yenthusiastic/EMRP19/media/web-login.png

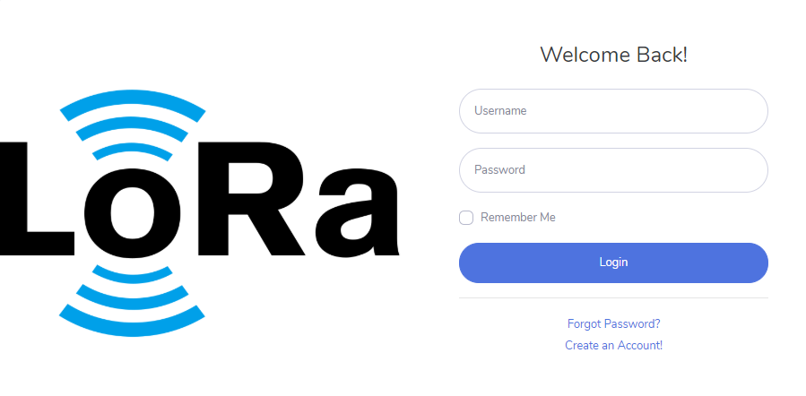
media/web-login.png
