yenthusiastic/EMRP19/code/database/paper_bins.csv

Name | Latitude | Longitude | lfd# Nr# | Stadtteil | Anzahl_beh | ort | Straße | Art | Abfuhrtag | Woche-g-ug | Telefon | Zeitbedarf
Papierkorb 200000402 | 51.41055037 | 6.584027857 | 1139 |  | 1 | Moers |  | Papierkorb |  |  |  | 0.5
Papierkorb 200001443 | 51.41388008 | 6.583538186 | 1140 |  | 1 | Moers |  | Papierkorb |  |  |  | 0.5
Papierkorb 200001526 | 51.40912285 | 6.591295972 | 1141 |  | 1 | Moers |  | Papierkorb |  |  |  | 0.5
Papierkorb 200001439 | 51.41414646 | 6.58943519 | 1142 |  | 1 | Moers |  | Papierkorb |  |  |  | 0.5
Papierkorb 200001440 | 51.41527005 | 6.589190606 | 1143 |  | 1 | Moers |  | Papierkorb |  |  |  | 0.5
Papierkorb 200001441 | 51.41563886 | 6.589281969 | 1144 |  | 1 | Moers |  | Papierkorb |  |  |  | 0.5
Papierkorb 200001436 | 51.42117812 | 6.585614551 | 1145 |  | 1 | Moers |  | Papierkorb |  |  |  | 0.5
Papierkorb 200000399 | 51.41945011 | 6.591256745 | 1146 |  | 1 | Moers |  | Papierkorb |  |  |  | 0.5
Papierkorb 200001432 | 51.4212601 | 6.588204056 | 1147 |  | 1 | Moers |  | Papierkorb |  |  |  | 0.5
Papierkorb 200001433 | 51.4211679 | 6.588633545 | 1148 |  | 1 | Moers |  | Papierkorb |  |  |  | 0.5
Papierkorb 200001434 | 51.42098693 | 6.588387201 | 1149 |  | 1 | Moers |  | Papierkorb |  |  |  | 0.5
Papierkorb 200001435 | 51.42090152 | 6.588645028 | 1150 |  | 1 | Moers |  | Papierkorb |  |  |  | 0.5
Papierkorb 200001437 | 51.42043029 | 6.588135744 | 1151 |  | 1 | Moers |  | Papierkorb |  |  |  | 0.5
Papierkorb 200001438 | 51.42075132 | 6.588340262 | 1152 |  | 1 | Moers |  | Papierkorb |  |  |  | 0.5
Papierkorb 200001442 | 51.42075811 | 6.588757345 | 1153 |  | 1 | Moers |  | Papierkorb |  |  |  | 0.5
Papierkorb 200001430 | 51.42186804 | 6.588427769 | 1154 |  | 1 | Moers |  | Papierkorb |  |  |  | 0.5
Papierkorb 200001431 | 51.42258176 | 6.588049075 | 1155 |  | 1 | Moers |  | Papierkorb |  |  |  | 0.5
Papierkorb 200000601 | 51.47922792 | 6.584357852 | 1156 |  | 1 | Moers |  | Papierkorb |  |  |  | 0.5
Papierkorb 200000605 | 51.47161908 | 6.591730574 | 1157 |  | 1 | Moers |  | Papierkorb |  |  |  | 0.5
Papierkorb 200000606 | 51.47160206 | 6.591788242 | 1158 |  | 1 | Moers |  | Papierkorb |  |  |  | 0.5
Papierkorb 200000602 | 51.47904695 | 6.588112274 | 1159 |  | 1 | Moers |  | Papierkorb |  |  |  | 0.5
Papierkorb 200000072 | 51.4902792 | 6.572217587 | 1160 |  | 1 | Moers |  | Papierkorb |  |  |  | 0.5
Papierkorb 200000070 | 51.4864884 | 6.589001091 | 1161 |  | 1 | Moers |  | Papierkorb |  |  |  | 0.5
Papierkorb 200000071 | 51.48623569 | 6.589025818 | 1162 |  | 1 | Moers |  | Papierkorb |  |  |  | 0.5
Papierkorb 200000068 | 51.48953808 | 6.591559835 | 1163 |  | 1 | Moers |  | Papierkorb |  |  |  | 0.5
Papierkorb 200000069 | 51.48918293 | 6.588444868 | 1164 |  | 1 | Moers |  | Papierkorb |  |  |  | 0.5
Papierkorb 200000435 | 51.48936734 | 6.590636065 | 1165 |  | 1 | Moers |  | Papierkorb |  |  |  | 0.5
Papierkorb 200000436 | 51.48910096 | 6.588473031 | 1166 |  | 1 | Moers |  | Papierkorb |  |  |  | 0.5
Papierkorb 200000437 | 51.49044994 | 6.586992955 | 1167 |  | 1 | Moers |  | Papierkorb |  |  |  | 0.5
Papierkorb 200000438 | 51.49082218 | 6.586709563 | 1168 |  | 1 | Moers |  | Papierkorb |  |  |  | 0.5
Papierkorb 200000439 | 51.49065823 | 6.586735966 | 1169 |  | 1 | Moers |  | Papierkorb |  |  |  | 0.5
Papierkorb 200000417 | 51.49748161 | 6.590841757 | 1170 |  | 1 | Moers |  | Papierkorb |  |  |  | 0.5
Papierkorb 200001476 | 51.40488815 | 6.60016587 | 1171 |  | 1 | Moers |  | Papierkorb |  |  |  | 0.5
Papierkorb 200001445 | 51.40803345 | 6.595880371 | 1172 |  | 1 | Moers |  | Papierkorb |  |  |  | 0.5
Papierkorb 200001446 | 51.40809154 | 6.595680965 | 1173 |  | 1 | Moers |  | Papierkorb |  |  |  | 0.5
Papierkorb 200001447 | 51.40809154 | 6.59616896 | 1174 |  | 1 | Moers |  | Papierkorb |  |  |  | 0.5
Papierkorb 200001448 | 51.40818031 | 6.595925633 | 1175 |  | 1 | Moers |  | Papierkorb |  |  |  | 0.5
Papierkorb 200001449 | 51.40824175 | 6.59592689 | 1176 |  | 1 | Moers |  | Papierkorb |  |  |  | 0.5
Papierkorb 200001450 | 51.40770899 | 6.595777022 | 1177 |  | 1 | Moers |  | Papierkorb |  |  |  | 0.5
Papierkorb 200001451 | 51.40768175 | 6.596020348 | 1178 |  | 1 | Moers |  | Papierkorb |  |  |  | 0.5
Papierkorb 200001478 | 51.40791737 | 6.596267531 | 1179 |  | 1 | Moers |  | Papierkorb |  |  |  | 0.5
Papierkorb 200001525 | 51.41023966 | 6.595593877 | 1180 |  | 1 | Moers |  | Papierkorb |  |  |  | 0.5
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
Papierkorb 200000852 | 51.462272 | 6.663483018 | 2248 |  | 1 | Moers |  | Papierkorb |  |  |  | 0.5
Papierkorb 200000416 | 51.50443138 | 6.58869884 | 2249 |  | 1 | Moers |  | Papierkorb |  |  |  | 0.5
