yenthusiastic/EMRP19/(commit log)

2020-01-17 upload code for single channel LORA Gateway
    [paper_bins.csv]
2020-01-17 upload codes for setting up database
    [paper_bins.csv]
2020-02-13 functional code! no encoding, no sensor data
2020-02-13 FULLY FUNCTIONALgit add code/garbage_bin__heltech_vl53l0x_ttn/git add code/garbage_bin__heltech_vl53l0x_ttn/ Sensor and deepsleep workinggit add code/garbage_bin__heltech_vl53l0x_ttn/11
2020-02-13 FULLY FUNCTIONAL! sensor and deepsleep!
2020-02-29 update link to housing
